fami-fish/c6/C6.kicad_pcb

## KiCad design C6.kicad_pcb (2024-11-28)

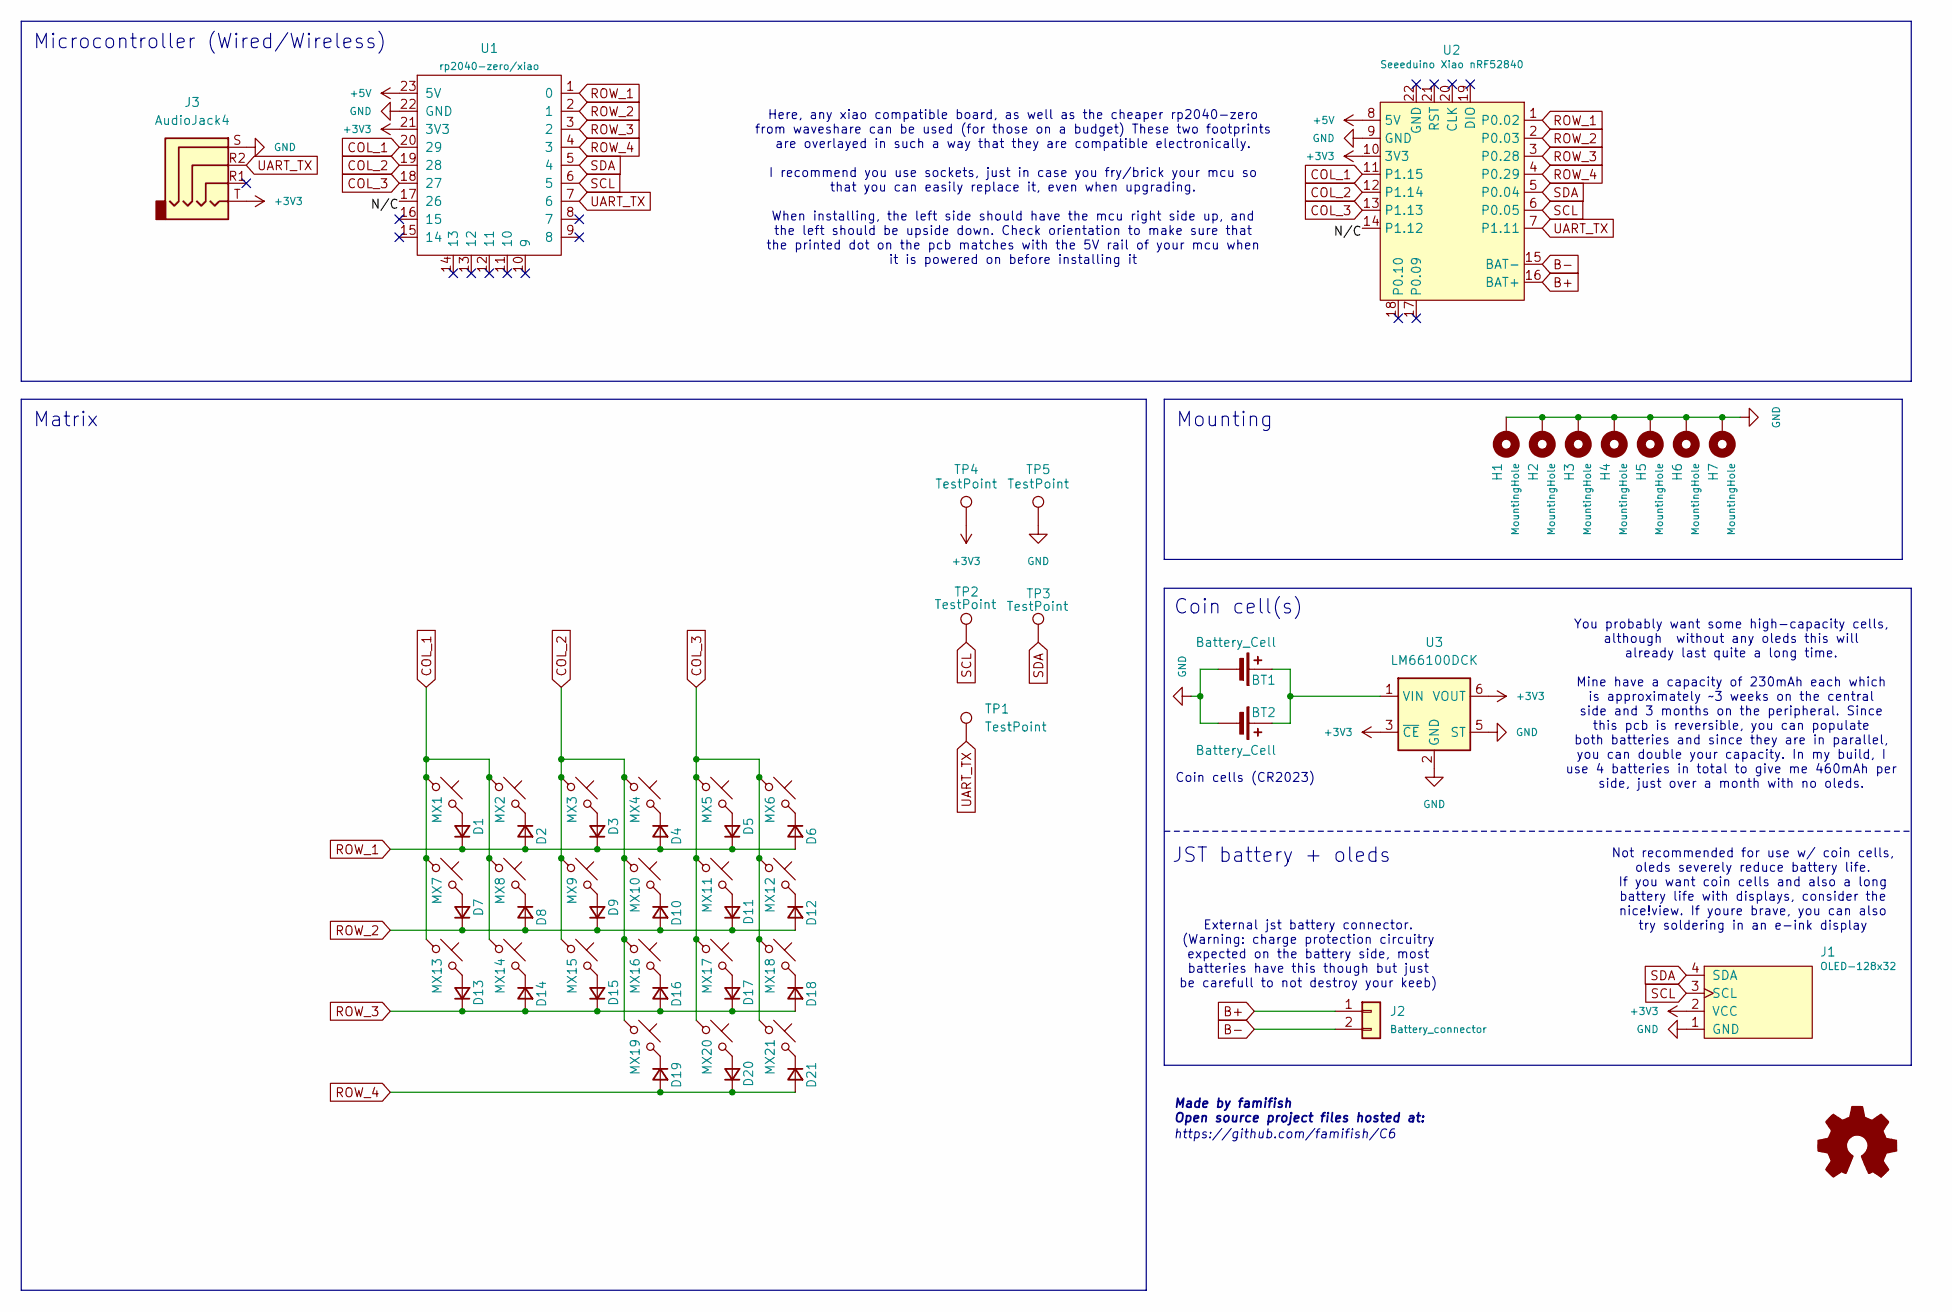
[picture p1: schematic C6.kicad_sch]

Parts:
BT1, BT2: Battery_Cell; BatteryHolder_Keystone_3034_1x20mm_HandSolder_design
D1, D2, D3, D4, D5, D6, D7, D8, D9, D10, D11, D12, D13, D14, D15, D16, D17, D18, D19, D20, D21: D_Small; Diode_THT_SMD
H1, H2, H3, H4, H5, H6, H7: MountingHole; MountingHole_2.2mm_M2_Pad
J1: OLED-128x32; OLED-128x32-double-sided
J2: Battery_connector; JST_PH_S2B-PH-K_1x02_P2.00mm_Horizontal_Reversible
J3: AudioJack4; CON_MJ-4PP-9_Reversible
MX1, MX2, MX3, MX4, MX5, MX6, MX7, MX8, MX9, MX10, MX11, MX12, MX13, MX14, MX15, MX16, MX17, MX18, MX20: MX_SW_solder; MX-Optional-Reversible-1U
MX19, MX21: MX_SW_solder; MX-Optional-Reversible-1.5U
TP1, TP2, TP3, TP4, TP5: TestPoint; TestPoint_Pad_D1.5mm
U1: rp2040-zero/xiao; rp2040-zero-tht
U2: Seeeduino Xiao nRF52840; Xiao_nRF52840_AH_Pogo
U3: LM66100DCK; SOT-363_SC-70-6_Handsoldering

Connections:
+3V3: J1.2 (VCC), J3.T, TP4.1, U1.21 (3V3), U2.10 (3V3), U3.3 (~CE), U3.6 (VOUT)
+5V: U1.23 (5V), U2.8 (5V)
/N/C: U1.17 (26), U2.14 (P1.12)
B+: J2.1, U2.16 (BAT+)
B-: J2.2, U2.15 (BAT-)
COL_1: MX1.1, MX2.1, MX7.1, MX8.1, MX13.1, MX14.1, U1.20 (29), U2.11 (P1.15)
COL_2: MX3.1, MX4.1, MX9.1, MX10.1, MX15.1, MX16.1, MX19.1, U1.19 (28), U2.12 (P1.14)
COL_3: MX5.1, MX6.1, MX11.1, MX12.1, MX17.1, MX18.1, MX20.1, MX21.1, U1.18 (27), U2.13 (P1.13)
GND: BT1.2 (-), BT2.2 (-), H1.1, H2.1, H3.1, H4.1, H5.1, H6.1, H7.1, J1.1 (GND), J3.S, TP5.1, U1.22 (GND), U2.9 (GND), U3.2 (GND), U3.5 (ST); also elsewhere on the board
unnamed 9: BT1.1 (+), BT2.1 (+), U3.1 (VIN); also elsewhere on the board
unnamed: D1.2 (A), MX1.2
unnamed: D2.1 (K), MX2.2
unnamed: D3.2 (A), MX3.2
unnamed: D4.1 (K), MX4.2
unnamed: D5.2 (A), MX5.2
unnamed: D6.1 (K), MX6.2
unnamed: D7.2 (A), MX7.2
unnamed: D8.1 (K), MX8.2
unnamed: D9.2 (A), MX9.2
unnamed: D10.1 (K), MX10.2
unnamed: D11.2 (A), MX11.2
unnamed: D12.1 (K), MX12.2
unnamed: D13.2 (A), MX13.2
unnamed: D14.1 (K), MX14.2
unnamed: D15.2 (A), MX15.2
unnamed: D16.1 (K), MX16.2
unnamed: D17.2 (A), MX17.2
unnamed: D18.1 (K), MX18.2
unnamed: D19.1 (K), MX19.2
unnamed: D20.2 (A), MX20.2
unnamed: D21.1 (K), MX21.2
ROW_1: D1.1 (K), D2.2 (A), D3.1 (K), D4.2 (A), D5.1 (K), D6.2 (A), U1.1 (0), U2.1 (P0.02)
ROW_2: D7.1 (K), D8.2 (A), D9.1 (K), D10.2 (A), D11.1 (K), D12.2 (A), U1.2 (1), U2.2 (P0.03)
ROW_3: D13.1 (K), D14.2 (A), D15.1 (K), D16.2 (A), D17.1 (K), D18.2 (A), U1.3 (2), U2.3 (P0.28)
ROW_4: D19.2 (A), D20.1 (K), D21.2 (A), U1.4 (3), U2.4 (P0.29)
SCL: J1.3 (SCL), TP2.1, U1.6 (5), U2.6 (P0.05)
SDA: J1.4 (SDA), TP3.1, U1.5 (4), U2.5 (P0.04)
UART_TX: J3.R2, TP1.1, U1.7 (6), U2.7 (P1.11)

Notes on the sheet:
Mounting
Microcontroller (Wired/Wireless)
Matrix
JST battery + oleds
External jst battery connector. (Warning: charge protection circuitry expected on the battery side, most batteries have this though but just be carefull to not destroy your keeb)
You probably want some high-capacity cells, although without any oleds this will already last quite a long time. Mine have a capacity of 230mAh each which is approximately ~3 weeks on the central side and 3 months on the peripheral. Since this pcb is reversible, you can populate both batteries and 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
Made by famifish Open source project files hosted at:
Coin cell(s)
Not recommended for use w/ coin cells, oleds severely reduce battery life. If you want coin cells and also a long battery life with displays, consider the nice!view. If youre brave, you can also try soldering in an e-ink display
https://github.com/famifish/C6
Here, any xiao compatible board, as well as the cheaper rp2040-zero from waveshare can be used (for those on a budget) These two footprints are overlayed in such a way that they are compatible electronically. I recommend you use sockets, just in case you fry/brick your mcu so that you can easily re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
Coin cells (CR2023)

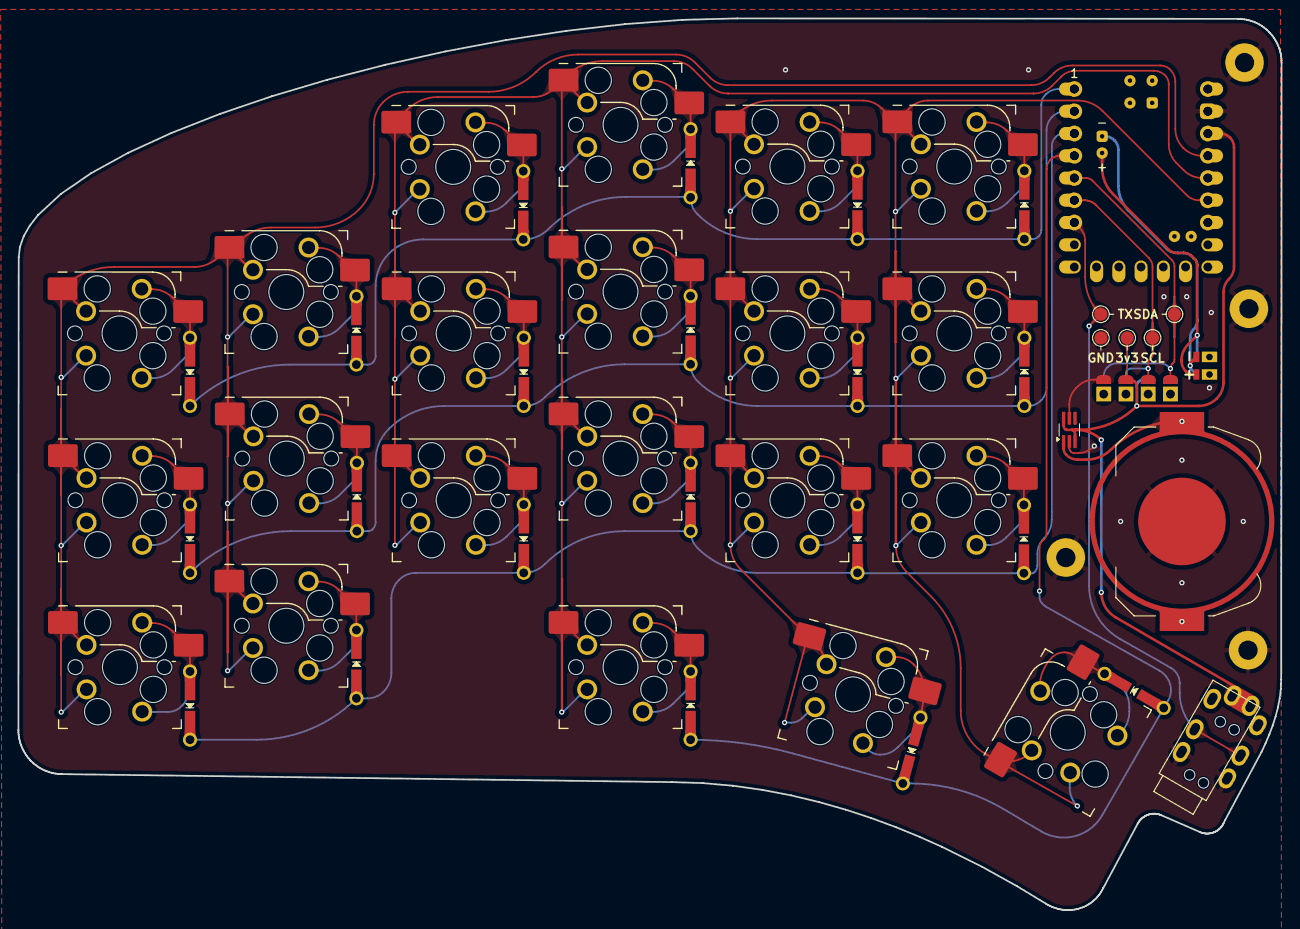
[picture p2: board C6.kicad_pcb from above]

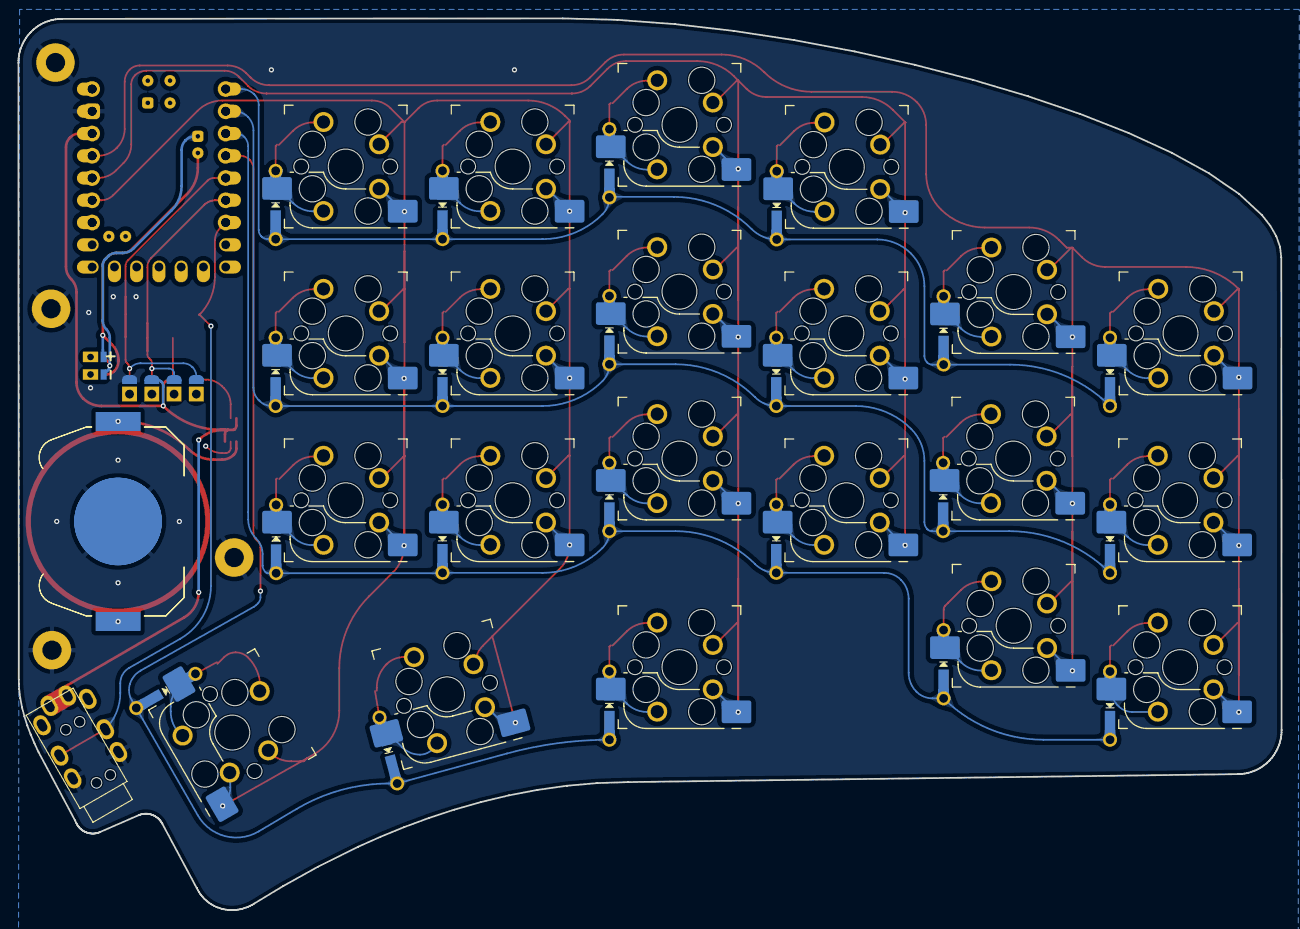
[picture p3: board C6.kicad_pcb from below]

Board: 2 copper layers, 144.2 x 101.8 mm, 60 parts (5 on the bottom side), 38 nets.

Other parts of the board:
BT1#2: Battery_Cell; BatteryHolder_Keystone_3034_1x20mm_HandSolder_design

Their connections:
GND: BT1#2.2 (-); also elsewhere on the board
unnamed 9: BT1#2.1 (+); also elsewhere on the board
